retr0embedded/Arduino-NIXIE-clock/Schematics/NixieClock.pdf

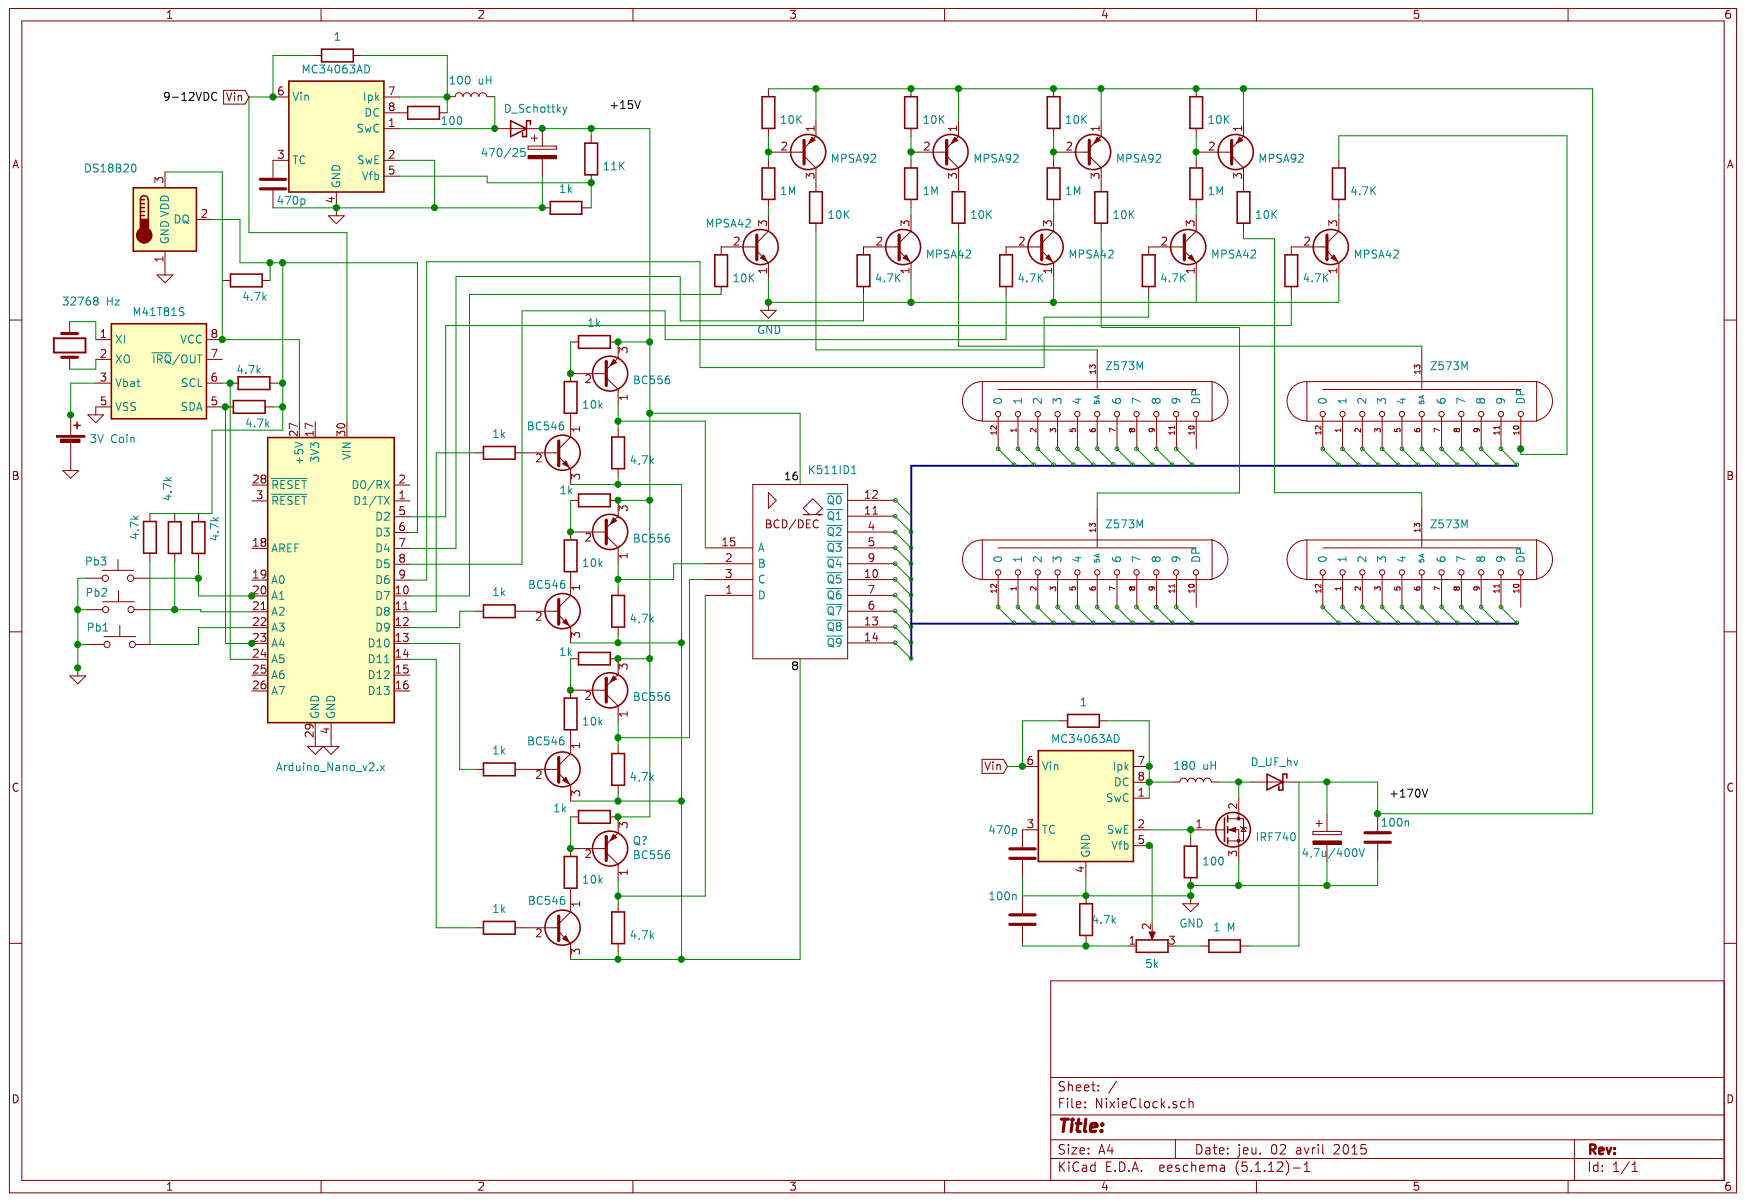
[picture p7: page 1]
