retr0embedded/Arduino-NIXIE-clock/Schematics/VFD_clock.pdf

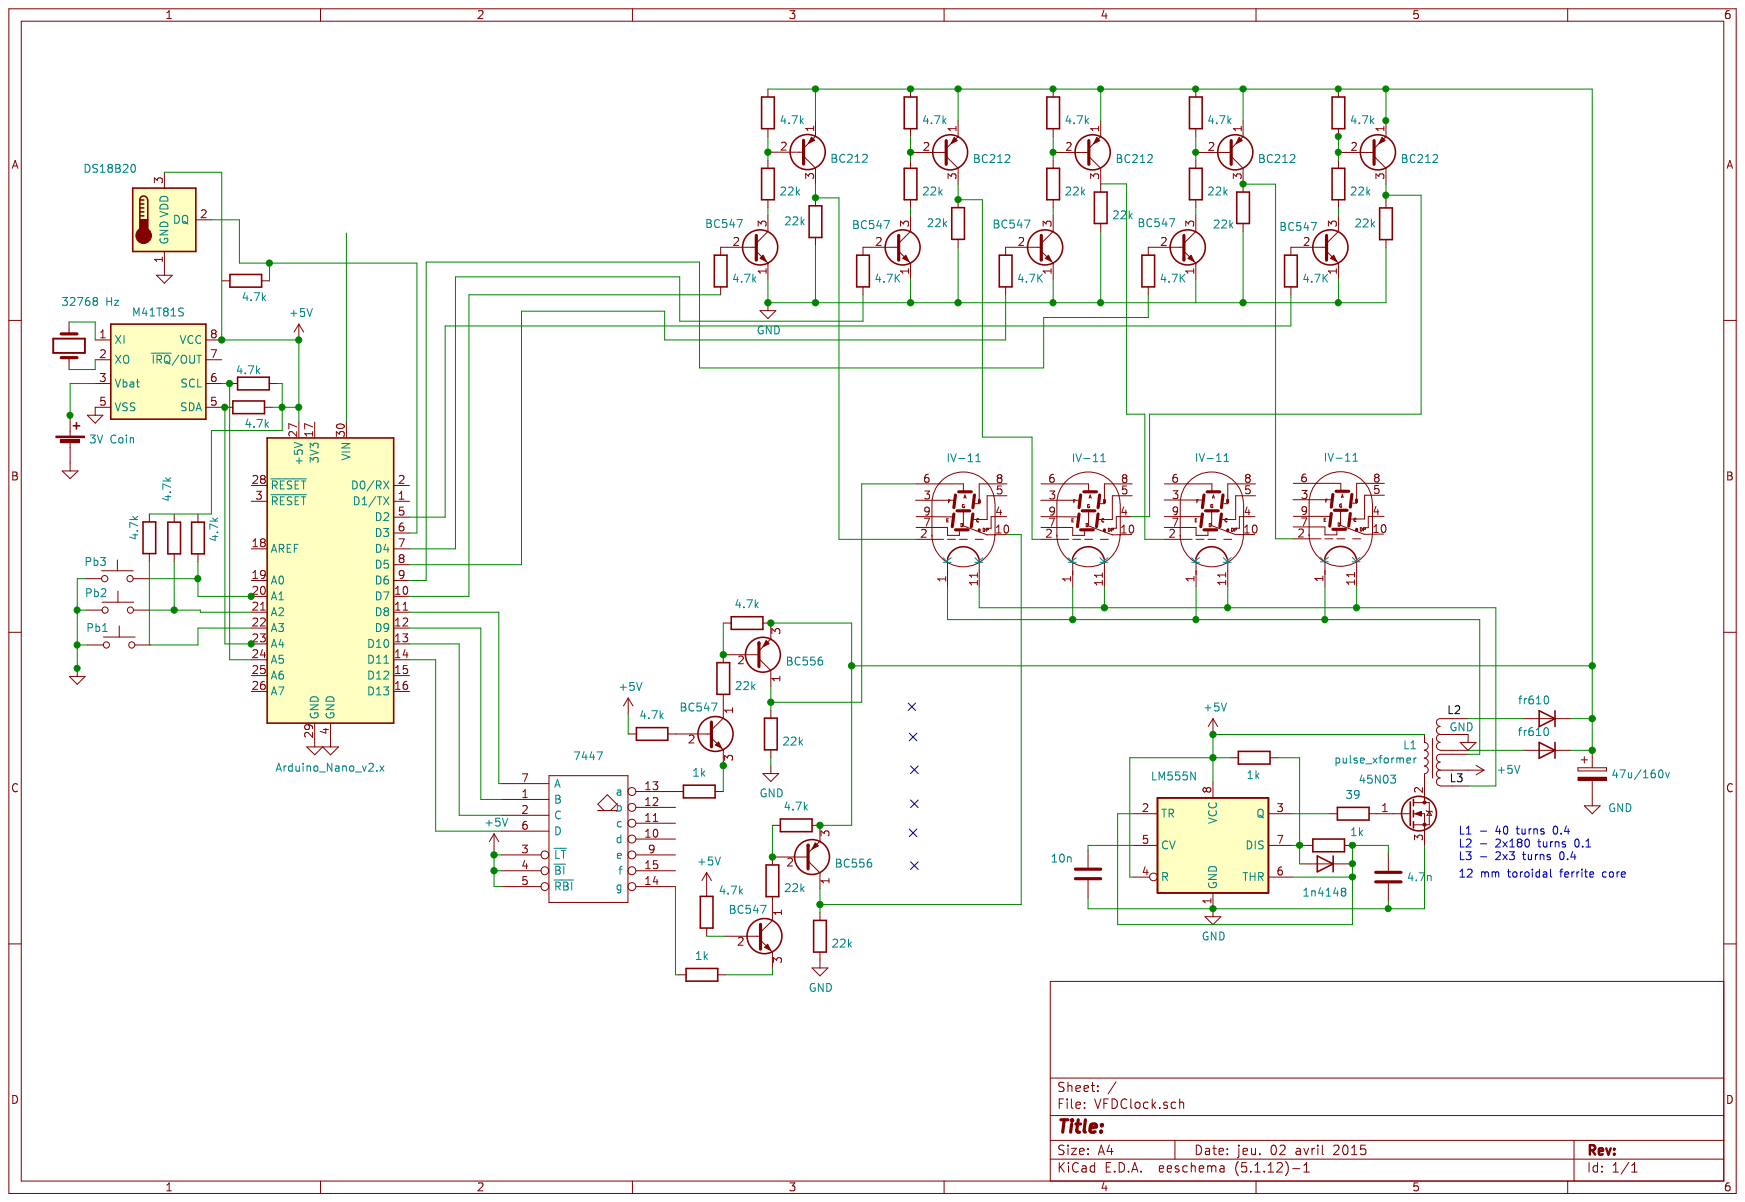
[picture p8: page 1]
