retr0embedded/Arduino-NIXIE-clock/(commit log)

2024-07-22 Added nixie and VFD clock schematics
    [NixieClock.sch, VFDClock.sch]
2024-08-08 For PCF8583 RTC and add an optional 4th button to display minutes/seconds
